ty19/RGBKeyboard/README.md

# RGBKeyboard
Custom RGB Keyboard PCB and Firmware project
