ty19/RGBKeyboard/PCB/40/Keyboard40.brd

## EAGLE design PCB/40/Keyboard40.brd (2020-02-28)

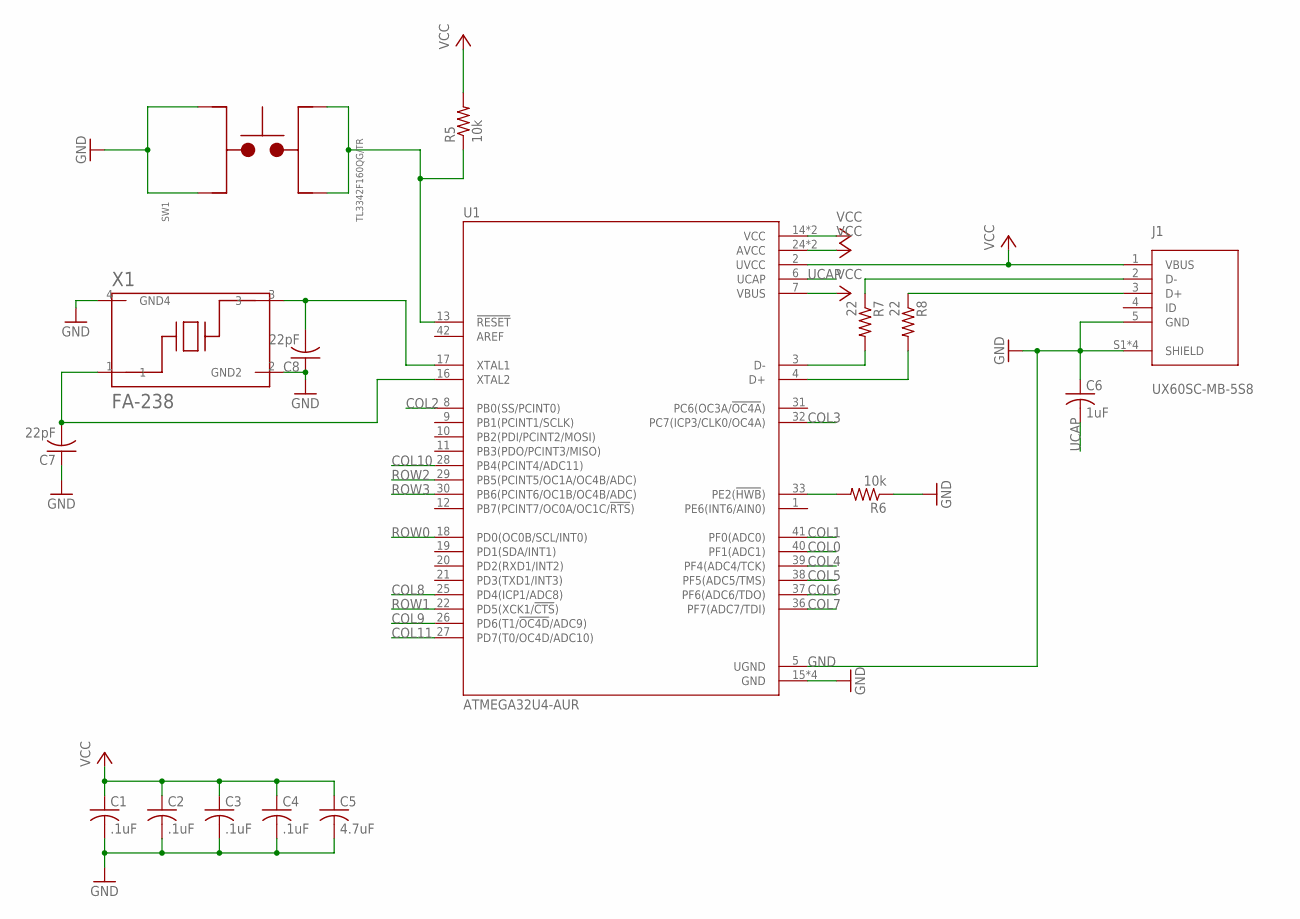
[picture p1: schematic Keyboard40.sch, sheet 1]

Parts:
C1, C2, C3, C4: .1uF; C0805
C5: 4.7uF; C0805
C6: 1uF; C0805
C7, C8: 22pF; C0805
J1: UX60SC-MB-5S8; HIROSE_UX60SC-MB-5S8
R5, R6: 10k; R0805
R7, R8: 22; R0805
SW1: TL3342F160QG/TR; SW_TL3342F160QG/TR
U1: ATMEGA32U4-AUR; QFP80P1200X1200X120-44N
X1: FA-238; OSCCC320X250X70-4N

Connections:
COL0: U1.40 (PF1(ADC1)); also elsewhere on the board
COL1: U1.41 (PF0(ADC0)); also elsewhere on the board
COL2: U1.8 (PB0(SS/PCINT0)); also elsewhere on the board
COL3: U1.32 (PC7(ICP3/CLK0/OC4A)); also elsewhere on the board
COL4: U1.39 (PF4(ADC4/TCK)); also elsewhere on the board
COL5: U1.38 (PF5(ADC5/TMS)); also elsewhere on the board
COL6: U1.37 (PF6(ADC6/TDO)); also elsewhere on the board
COL7: U1.36 (PF7(ADC7/TDI)); also elsewhere on the board
COL8: U1.25 (PD4(ICP1/ADC8)); also elsewhere on the board
COL9: U1.26 (PD6(T1/!OC4D!/ADC9)); also elsewhere on the board
COL10: U1.28 (PB4(PCINT4/ADC11)); also elsewhere on the board
COL11: U1.27 (PD7(T0/OC4D/ADC10)); also elsewhere on the board
GND: C1.2, C2.2, C3.2, C4.2, C5.2, C6.1, C7.1, C8.1, J1.5 (GND), J1.S1 (SHIELD), J1.S2 (SHIELD), J1.S3 (SHIELD), J1.S4 (SHIELD), R6.1, SW1.3, SW1.4, U1.5 (UGND), U1.15 (GND), U1.23 (GND), U1.35 (GND), U1.43 (GND), X1.2 (GND2), X1.4 (GND4)
unnamed: C8.2, U1.17 (XTAL1), X1.3
unnamed: C7.2, U1.16 (XTAL2), X1.1
unnamed: R5.1, SW1.1, SW1.2, U1.13 (!RESET)
unnamed: R6.2, U1.33 (PE2(!HWB!))
unnamed: R7.2, U1.3 (D-)
unnamed: J1.2 (D-), R7.1
unnamed: R8.2, U1.4 (D+)
unnamed: J1.3 (D+), R8.1
ROW0: U1.18 (PD0(OC0B/SCL/INT0)); also elsewhere on the board
ROW1: U1.22 (PD5(XCK1/!CTS!)); also elsewhere on the board
ROW2: U1.29 (PB5(PCINT5/OC1A/OC4B/ADC)); also elsewhere on the board
ROW3: U1.30 (PB6(PCINT6/OC1B/OC4B/ADC)); also elsewhere on the board
UCAP: C6.2, U1.6 (UCAP)
VCC: C1.1, C2.1, C3.1, C4.1, C5.1, J1.1 (VBUS), R5.2, U1.2 (UVCC), U1.7 (VBUS), U1.14 (VCC), U1.24 (AVCC), U1.34 (VCC), U1.44 (AVCC)

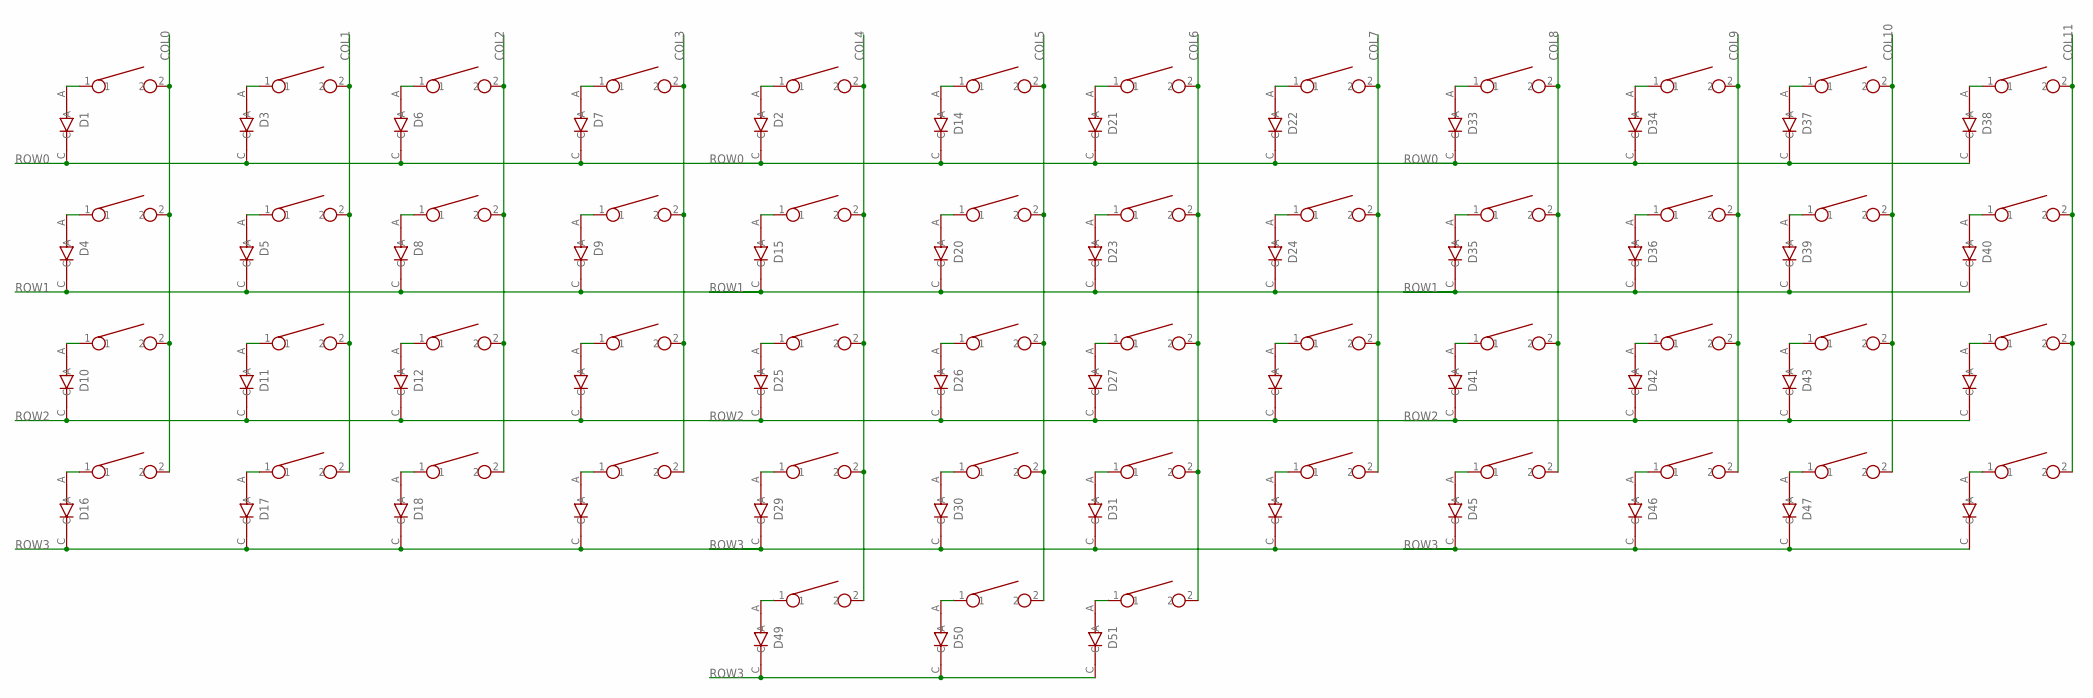
[picture p2: schematic Keyboard40.sch, sheet 2]

Parts:
D1, D2, D3, D4, D5, D6, D7, D8, D9, D10, D11, D12, D13, D14, D15, D16, D17, D18, D19, D20, D21, D22, D23, D24, D25, D26, D27, D28, D29, D30, D31, D32, D33, D34, D35, D36, D37, D38, D39, D40, D41, D42, D43, D44, D45, D46, D47, D48, D49, D50, D51: BAV21W-7-F; SOD3715X135N
U$1, U$2, U$3, U$4, U$5, U$6, U$7, U$8, U$9, U$10, U$11, U$12, U$16, U$17, U$18, U$19, U$20, U$21, U$22, U$23, U$24, U$25, U$26, U$27, U$28, U$29, U$30, U$31, U$32, U$33, U$34, U$35, U$36, U$37, U$38, U$39, U$40, U$41, U$42, U$43, U$44, U$45, U$46, U$47, U$48, U$49, U$50, U$51: CHERRY_MXCHERRY_MX_PLATE; CHERRY_MX_PLATE
U$13, U$14, U$15: CHERRY_MXCHERRY_MX_1_2_PLATE; CHERRY_MX_1_2_PLATE

Connections:
COL0: U$1.2, U$2.2, U$3.2, U$17.2; also elsewhere on the board
COL1: U$4.2, U$5.2, U$6.2, U$18.2; also elsewhere on the board
COL2: U$7.2, U$8.2, U$9.2, U$19.2; also elsewhere on the board
COL3: U$10.2, U$11.2, U$12.2, U$16.2; also elsewhere on the board
COL4: U$13.2, U$22.2, U$23.2, U$24.2, U$36.2; also elsewhere on the board
COL5: U$14.2, U$25.2, U$26.2, U$27.2, U$37.2; also elsewhere on the board
COL6: U$15.2, U$28.2, U$29.2, U$30.2, U$38.2; also elsewhere on the board
COL7: U$20.2, U$21.2, U$31.2, U$35.2; also elsewhere on the board
COL8: U$34.2, U$39.2, U$40.2, U$49.2; also elsewhere on the board
COL9: U$41.2, U$42.2, U$43.2, U$50.2; also elsewhere on the board
COL10: U$44.2, U$45.2, U$46.2, U$51.2; also elsewhere on the board
COL11: U$32.2, U$33.2, U$47.2, U$48.2; also elsewhere on the board
unnamed: D9.A, U$10.1
unnamed: D5.A, U$5.1
unnamed: D7.A, U$12.1
unnamed: D20.A, U$26.1
unnamed: D14.A, U$25.1
unnamed: D3.A, U$4.1
unnamed: D11.A, U$6.1
unnamed: D13.A, U$11.1
unnamed: D16.A, U$17.1
unnamed: D19.A, U$16.1
unnamed: D49.A, U$13.1
unnamed: D17.A, U$18.1
unnamed: D24.A, U$20.1
unnamed: D22.A, U$31.1
unnamed: D26.A, U$27.1
unnamed: D28.A, U$21.1
unnamed: D25.A, U$24.1
unnamed: D2.A, U$22.1
unnamed: D15.A, U$23.1
unnamed: D21.A, U$28.1
unnamed: D23.A, U$29.1
unnamed: D27.A, U$30.1
unnamed: D36.A, U$42.1
unnamed: D6.A, U$7.1
unnamed: D32.A, U$35.1
unnamed: D8.A, U$8.1
unnamed: D12.A, U$9.1
unnamed: D10.A, U$3.1
unnamed: D1.A, U$1.1
unnamed: D4.A, U$2.1
unnamed: D30.A, U$37.1
unnamed: D31.A, U$38.1
unnamed: D29.A, U$36.1
unnamed: D34.A, U$41.1
unnamed: D40.A, U$32.1
unnamed: D38.A, U$47.1
unnamed: D42.A, U$43.1
unnamed: D44.A, U$33.1
unnamed: D41.A, U$40.1
unnamed: D33.A, U$34.1
unnamed: D35.A, U$39.1
unnamed: D37.A, U$44.1
unnamed: D39.A, U$45.1
unnamed: D43.A, U$46.1
unnamed: D48.A, U$48.1
unnamed: D47.A, U$51.1
unnamed: D45.A, U$49.1
unnamed: D46.A, U$50.1
unnamed: D18.A, U$19.1
unnamed: D50.A, U$14.1
unnamed: D51.A, U$15.1
ROW0: D1.C, D2.C, D3.C, D6.C, D7.C, D14.C, D21.C, D22.C, D33.C, D34.C, D37.C, D38.C; also elsewhere on the board
ROW1: D4.C, D5.C, D8.C, D9.C, D15.C, D20.C, D23.C, D24.C, D35.C, D36.C, D39.C, D40.C; also elsewhere on the board
ROW2: D10.C, D11.C, D12.C, D13.C, D25.C, D26.C, D27.C, D28.C, D41.C, D42.C, D43.C, D44.C; also elsewhere on the board
ROW3: D16.C, D17.C, D18.C, D19.C, D29.C, D30.C, D31.C, D32.C, D45.C, D46.C, D47.C, D48.C, D49.C, D50.C, D51.C; also elsewhere on the board

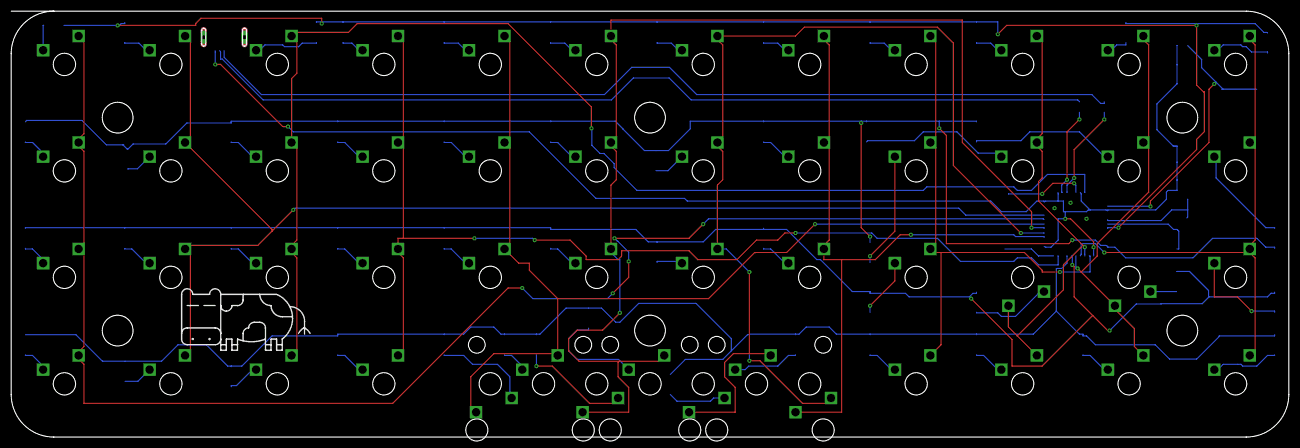
[picture p3: board Keyboard40.brd from above]

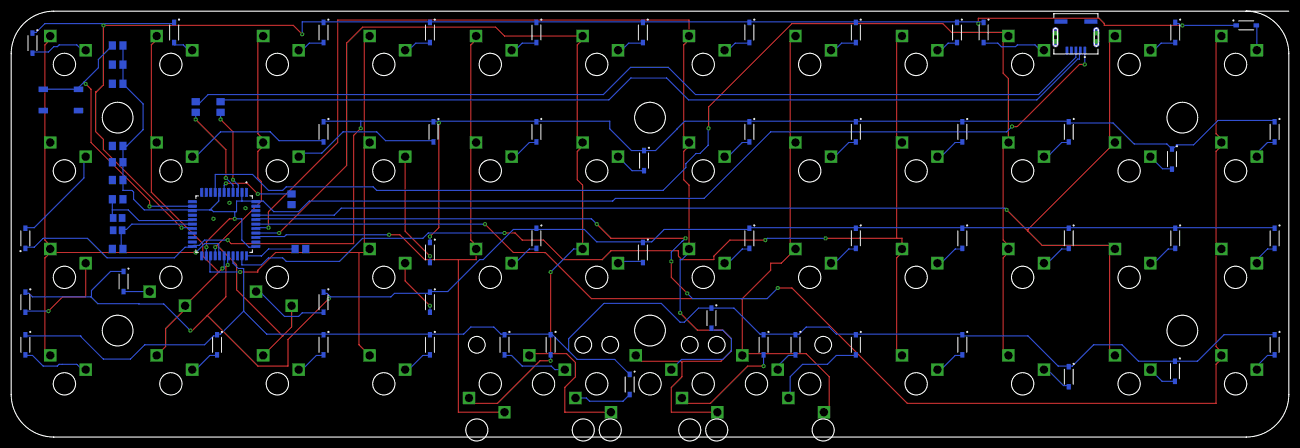
[picture p4: board Keyboard40.brd from below]

Board: 2 copper layers, 228.6 x 76.2 mm, 118 parts (67 on the bottom side), 78 nets.
