ty19/RGBKeyboard/(commit log)

2019-07-10 Initial board file
    [RGBKeyboard.sch]
2019-07-10 MSP430F5529 and Cherry MX Switch libs
2019-07-11 USB lib and schematic
    [RGBKeyboard.sch]
2019-07-11 Switches with LEDs and diodes
    [RGBKeyboard.sch]
2019-07-12 Add holes for 2u and 6u led switches.
2019-07-12 Double check power and add headers
    Power is sourced from USB through VBUS, goes through
    internal LDO to VUSB and goes to DVCC.
    Headers are for row/col debug and Spi-By-Wire
    [RGBKeyboard.sch]
2019-07-13 Add power debug pins and double check connections
    [RGBKeyboard.sch]
2019-07-13 Temp board and schematic (commit for progress)
    Will be switching to a simpler design using the MSP430F5529
    launchpad because the tools I have right now make it hard to
    solder the MSP430 onto the board. Instead, the launchpad will
    be connected to the board using header pins.
    [RGBKeyboard.brd, RGBKeyboard.sch]
2019-07-13 Have a decent prototype but may switch LEDs
    WS2812-2020s seem easier to solder but are harder to control.
    [RGBKeyboard.brd, RGBKeyboard.sch]
2019-07-13 Schematic and Board for first prototype
    Ended up removing the LEDs entirely (rip) because
    there was too much uncertainty with dimensions
    and routing was annoying
    [RGBKeyboard.brd, RGBKeyboard.sch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]
2019-07-14 Add Bill of Materials
    [RGBKeyboard.csv]
2019-07-14 Shrink board to < 100 mm x 100 mm
    PCB Manufacturers (e.g. Seeed Studio) offer very cheap (~$5) prototype
    PCBs that are under 100 mm x 100 mm, after which the costs increase
    [RGBKeyboard.brd, RGBKeyboard.csv, RGBKeyboard.sch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]
2019-07-14 Further reduce size by changing spacing
    [RGBKeyboard.brd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]
2019-10-23 Minor cleanup
    [RGBKeyboard.sch]
2019-10-25 New board design for 16 percent
    [RGBKeyboard.brd, RGBKeyboard.sch]
2019-10-29 Make holes smaller. 19mm key spacing
    [RGBKeyboard.brd, RGBKeyboard.sch]
2019-11-16 Create 40% layout
    [Keyboard40.brd, Keyboard40.sch, RGBKeyboard.brd, RGBKeyboard.sch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]
2019-11-16 Output files for 40
    [Keyboard40.brd, Keyboard40.sch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]
2019-11-16 Cleanup. Add holes and use plate switches
    [Keyboard40.brd, Keyboard40.sch]
2019-11-16 Increase hole tolerance and round edges
    [Keyboard40.brd]
2019-12-18 VUSB to VCC. Fix USB position
    [Keyboard40.brd, Keyboard40.sch]
2020-02-28 Holes for new case
    [Keyboard40.brd]
